clytle374/VTVM-Battery-Eliminator/VTVMbatElem.ods

Index | Manufacturer Part Number | Manufacturer Name | Description | Customer Reference
1 | ZPI03S0600WC | Zettler Magnetics | 3W AC-DC POWER SUPPLY HIGH AMBIE | PS1
2 | KGM31DR72A104KU | KYOCERA AVX | CAP CER 0.1UF 100V X7R 1206 | C1 C2 C4
3 | LM317MDCYR | Texas Instruments | IC REG LIN POS ADJ 500MA SOT223 | U1
4 | 01500332H | Littelfuse Inc. | FUSE HLDR CART 250V 15A IN LINE
5 | 2057-440-AL | RAF Electronic Hardware | HEX STANDOFF #4-40 ALUMINUM 1/2"
6 | ECF440 | L-com | MACHINE SCREWS 4-40X5/16"
7 | RC1206FR-071K5L | YAGEO | RES 1.5K OHM 1% 1/4W 1206 | 3V0 R1
8 | RC1206FR-13300RL | YAGEO | RES 300 OHM 1% 1/4W 1206 | 3V0 R2
9 | RC1206FR-07240RL | YAGEO | RES 240 OHM 1% 1/4W 1206 | R3
10 | RC1206FR-07150RL | YAGEO | RES 150 OHM 1% 1/4W 1206 | 1V5 R1
11 | CRCW1206120RJNEAHP | Vishay Dale | RES SMD 120 OHM 5% 3/4W 1206 | 1V5 R5
12 | CRCW1206220RFKEAHP | Vishay Dale | RES SMD 220 OHM 1% 3/4W 1206 | 3V0 R5
13 | 3296W-1-201LF | Bourns Inc. | TRIMMER 200 OHM 0.5W PC PIN TOP | 3V0 RV1
14 | 3296W-1-500LF | Bourns Inc. | TRIMMER 50 OHM 0.5W PC PIN TOP | 1V5 RV1
15 | A7 | Good-Ark Semiconductor | RECTIFIER, GENERAL PURPOSE, 1A, | D1 D2
16 | RC1206FR-0756RL | YAGEO | RES 56 OHM 1% 1/4W 1206 | 1V5 R2
17 | 3403.0160.11 | SCHURTER Inc. | FUSE BRD MNT 250MA 250VAC 125VDC | F1
18 | BK/AGC-6/10-R | Eaton - Electronics Division | FUSE GLASS 600MA 250VAC 3AB 3AG | fuse
19 | SMBJ5V0A | Taiwan Semiconductor Corporation | TVS DIODE 5VWM 9.2VC DO214AA | newer newest D3 OMG
