clytle374/VTVM-Battery-Eliminator/freecadPCBtest.FCStd

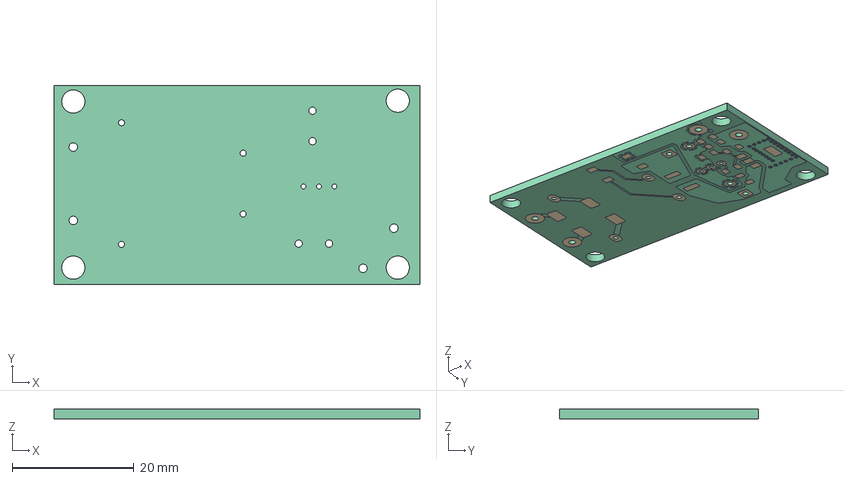
[picture p1: CAD file, 2024-07-20]
freecadPCBtest.FCStd
60.2 x 32.8 x 1.62 mm
Pcb_dbea
botPads_dbea
botTracks_dbea
botZones_dbea
