clytle374/VTVM-Battery-Eliminator/drillGuide-BodyPad001.3mf

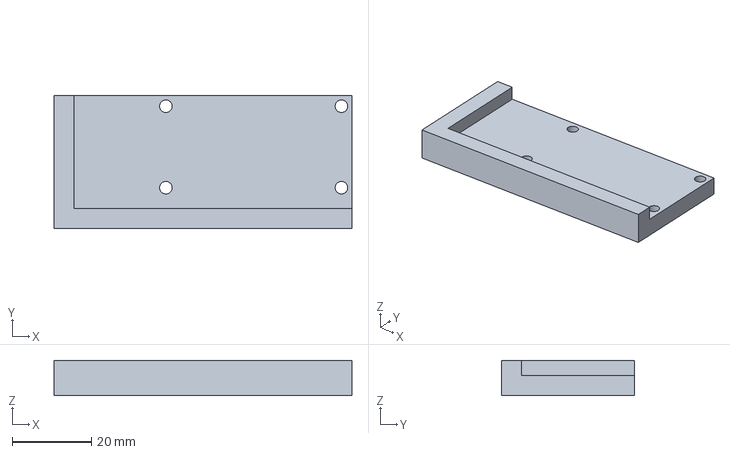
[picture p2: CAD file, 2024-07-20]
drillGuide-BodyPad001.3mf
75.4 x 33.8 x 8.89 mm
