clytle374/VTVM-Battery-Eliminator/drillGuide.FCStd

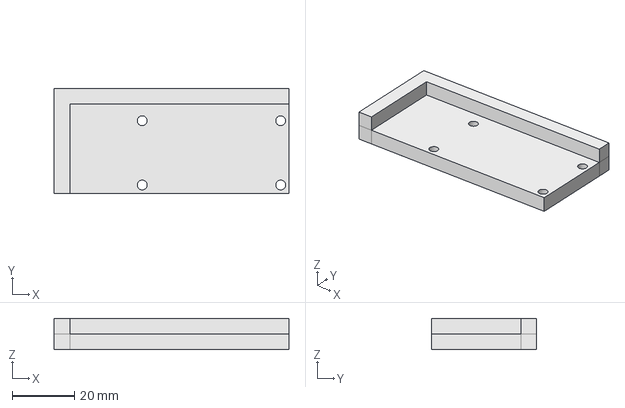
[picture p3: CAD file, 2024-07-20]
drillGuide.FCStd
75.4 x 33.8 x 10.0 mm
