clytle374/VTVM-Battery-Eliminator/(list of files, cad)

Other CAD files:
drillGuide-BodyPad001.stl
