clytle374/VTVM-Battery-Eliminator/VTVMbattElim-B_Cu.pdf

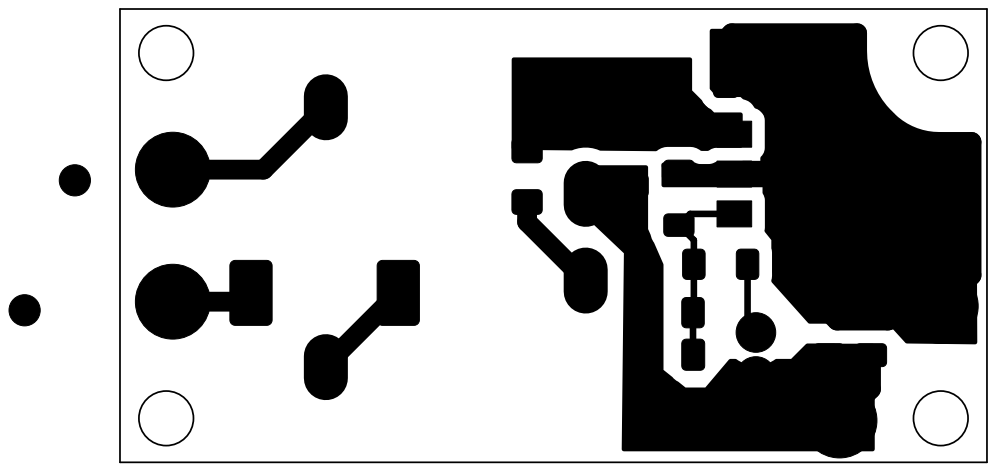
[picture p4: page 1]
