clytle374/VTVM-Battery-Eliminator/VTVMbattElim.kicad_pcb

## KiCad design VTVMbattElim.kicad_pcb (2024-07-20)

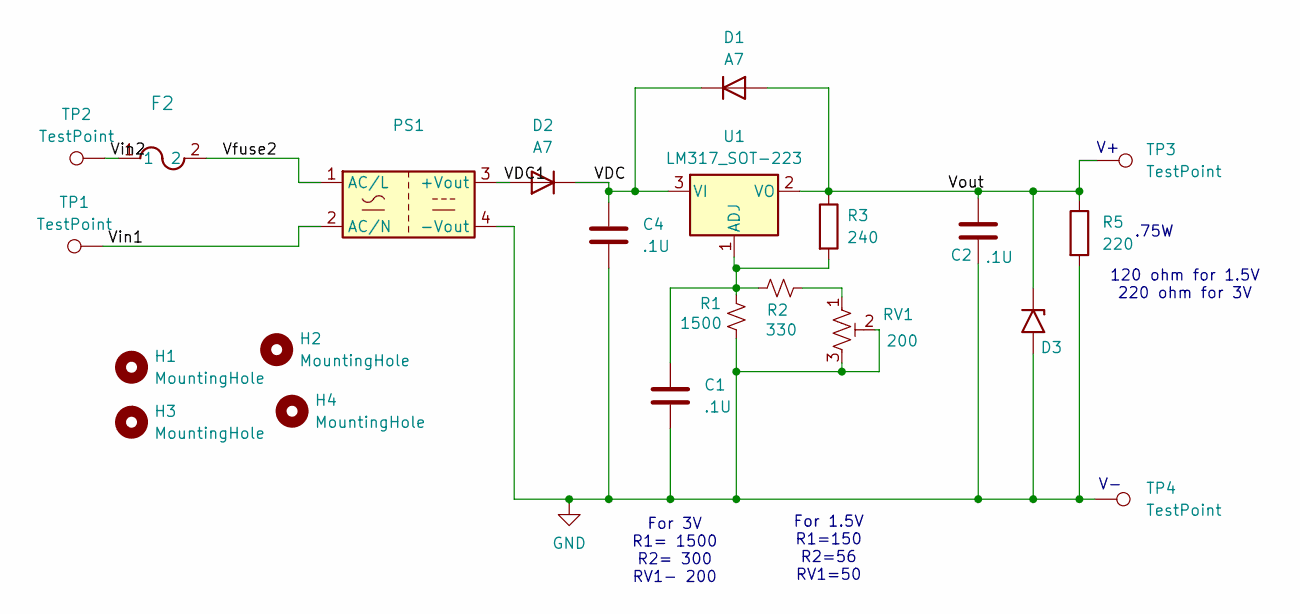
[picture p5: schematic VTVMbattElim.kicad_sch]

Parts:
C1, C2, C4: .1U; C_1206_3216Metric_Pad1.33x1.80mm_HandSolder
D1, D2: A7; D_SOD-123F-HandSolder
D3: SMAJ6.5A-13-F; D_SMA-SMB_Universal_Handsoldering
F2: 0034.6000; Fuse_Schurter_UMT250
H1, H2, H3, H4: MountingHole; MountingHole_3.2mm_M3
PS1: ZPI03S0600WC
R1: 1500; R_1206_3216Metric_Pad1.30x1.75mm_HandSolder
R2: 330; R_1206_3216Metric_Pad1.30x1.75mm_HandSolder
R3: 240; R_1206_3216Metric_Pad1.30x1.75mm_HandSolder
R5: 220; R_1206_3216Metric_Pad1.30x1.75mm_HandSolder
RV1: 200; Potentiometer_Bourns_3296W_Vertical
TP1, TP2, TP3, TP4: TestPoint; Pin_D1.4mm_L8.5mm_W2.8mm_FlatFork
U1: LM317_SOT-223; SOT-223-3_TabPin2

Connections:
/VDC: C4.1, D1.1 (K), D2.1 (K), U1.3 (VI)
/VDC1: D2.2 (A), PS1.3 (+Vout)
/Vfuse2: F2.2, PS1.1 (AC/L)
/Vin1: PS1.2 (AC/N), TP1.1
/Vin2: F2.1, TP2.1
/Vout: C2.1, D1.2 (A), D3.1 (A1), R3.1, R5.1, TP3.1, U1.2 (VO)
GND: C1.2, C2.2, C4.2, D3.2 (A2), PS1.4 (-Vout), R1.2, R5.2, RV1.2, RV1.3, TP4.1
unnamed: R2.2, RV1.1
unnamed: C1.1, R1.1, R2.1, R3.2, U1.1 (ADJ)

Notes on the sheet:
.75W
120 ohm for 1.5V 220 ohm for 3V
For 1.5V R1=150 R2=56 RV1=50
For 3V R1= 1500 R2= 300 RV1- 200

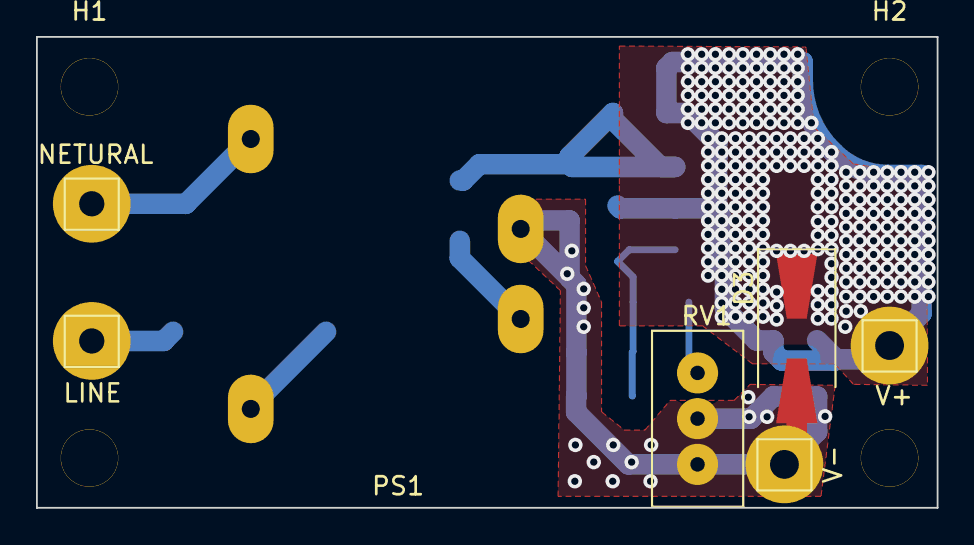
[picture p6: board VTVMbattElim.kicad_pcb from above]

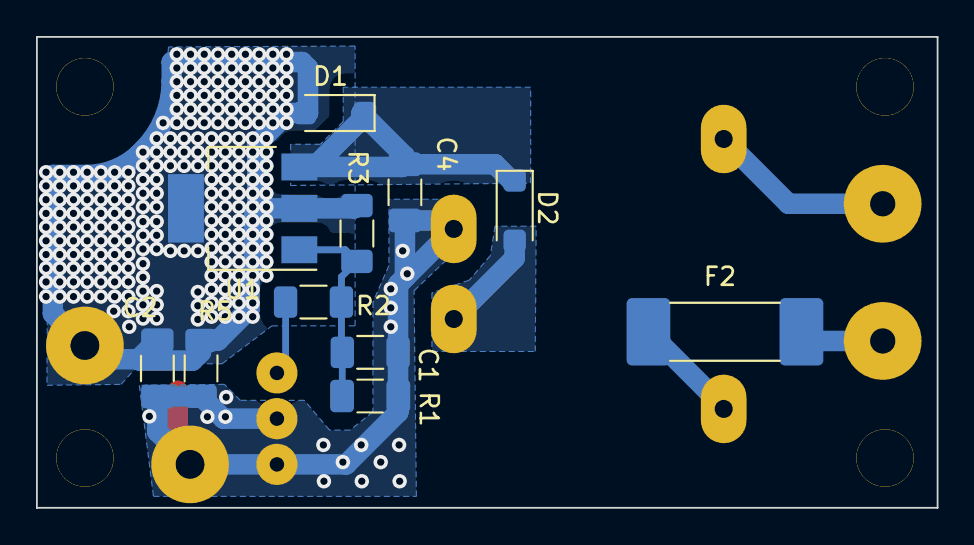
[picture p7: board VTVMbattElim.kicad_pcb from below]

Board: 2 copper layers, 50.0 x 26.2 mm, 22 parts (11 on the bottom side), 9 nets.
